MajenkoProjects/RTmFM/RTmFM.kicad_pcb

## KiCad design RTmFM.kicad_pcb (2026-05-27)

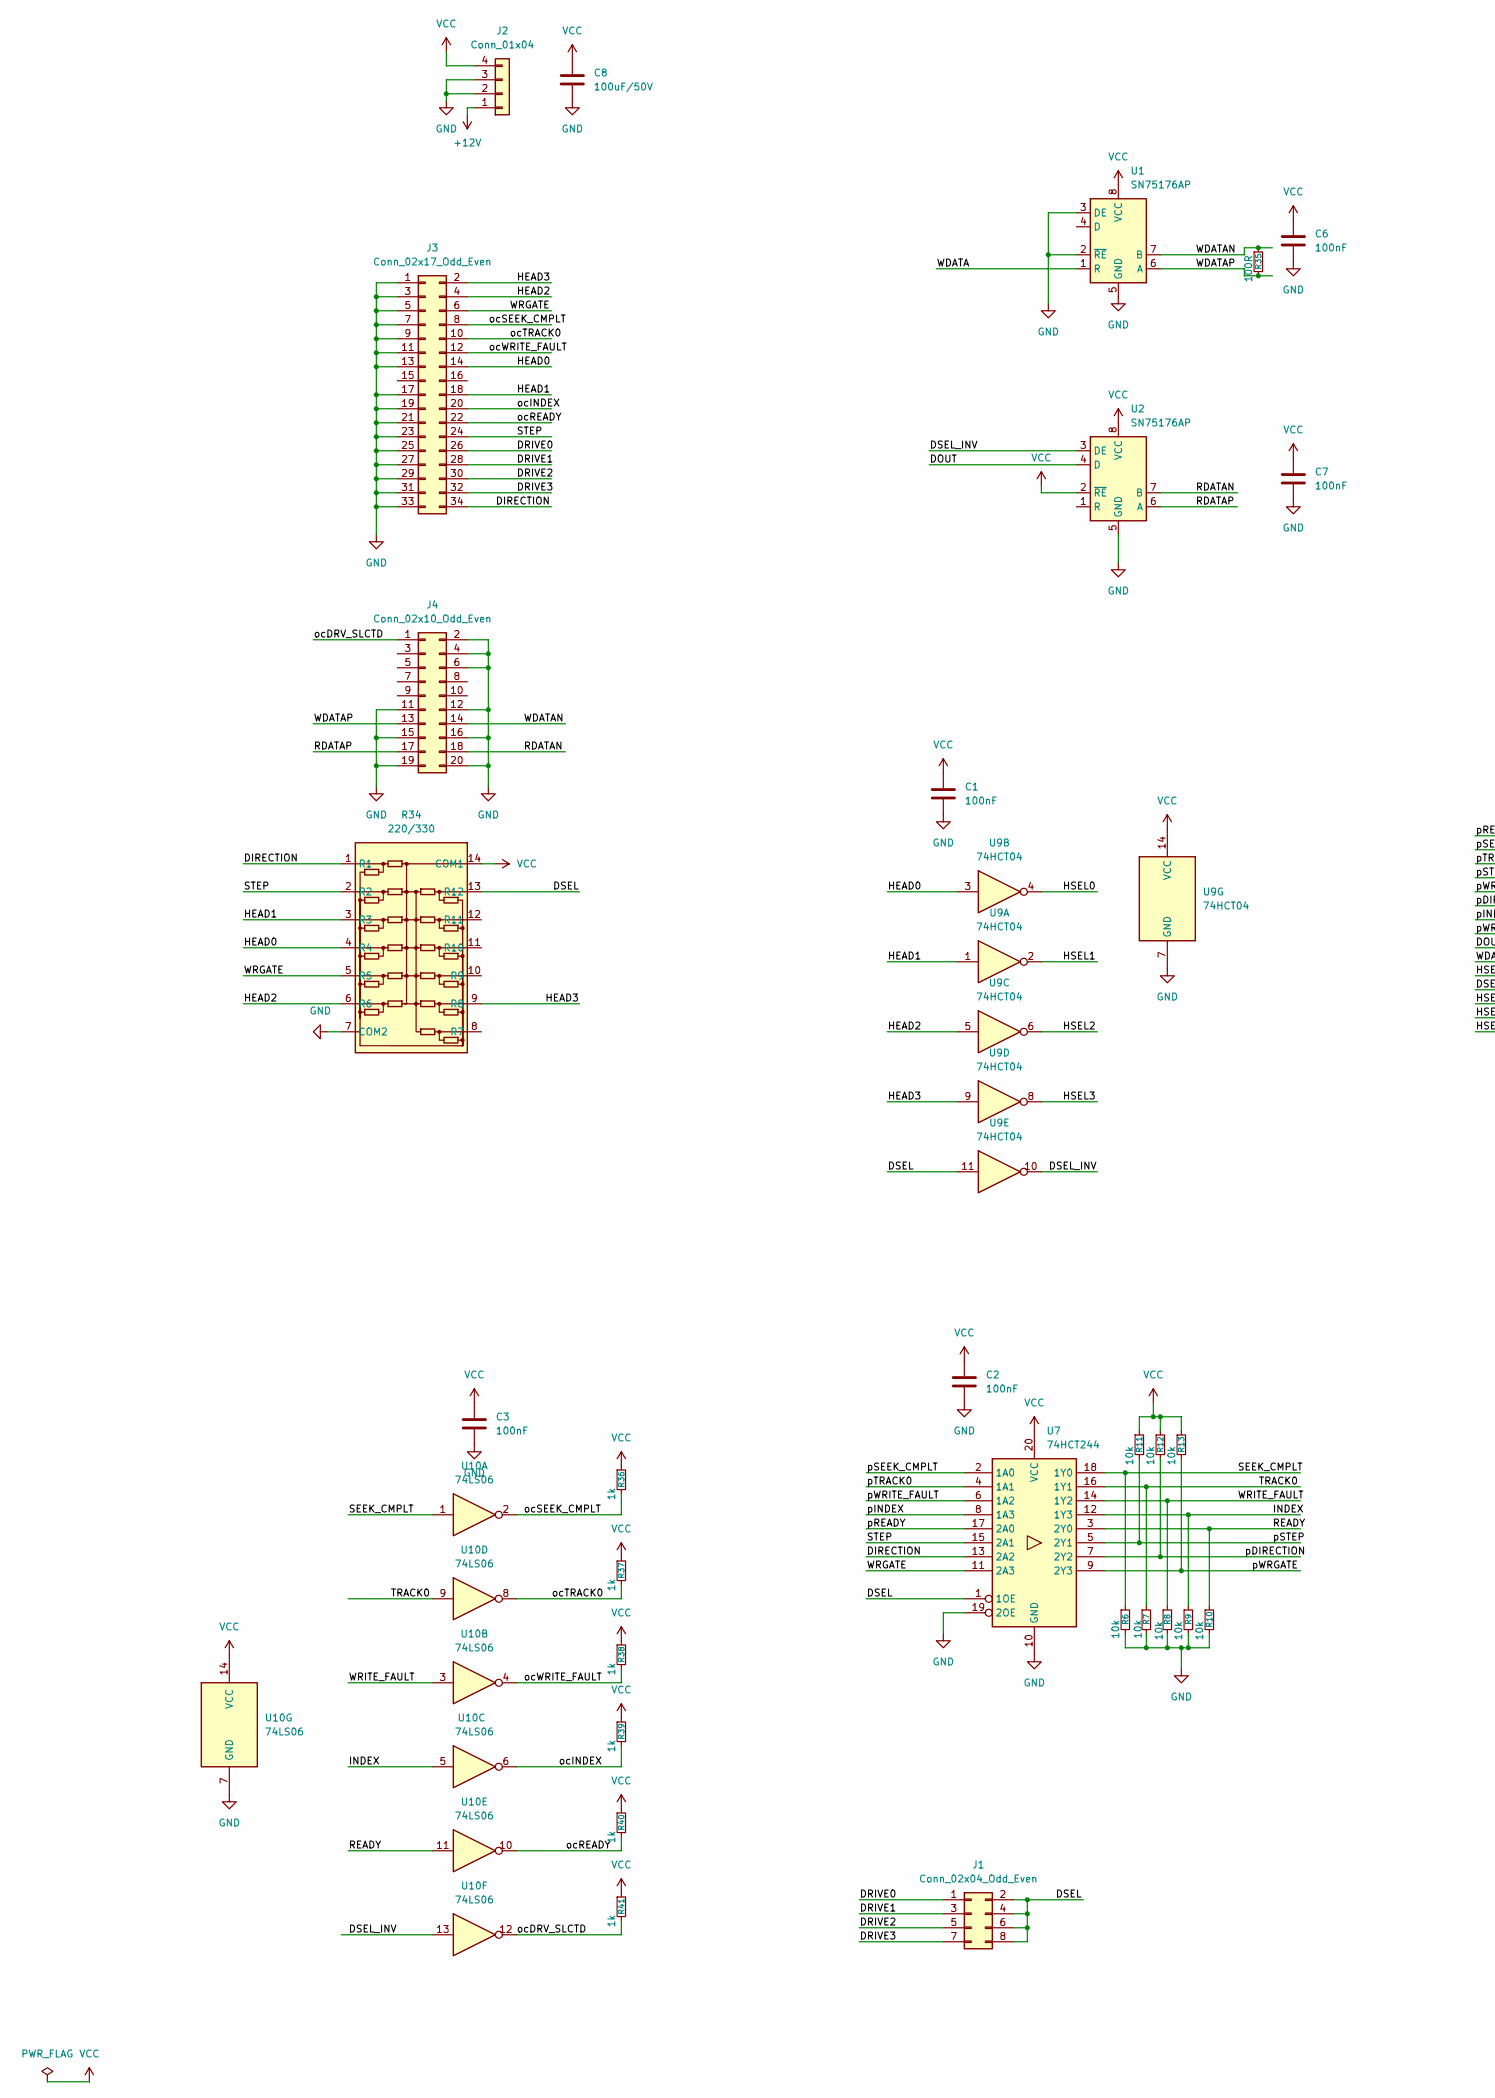
[picture p1: schematic RTmFM.kicad_sch, part in row 1, column 1]

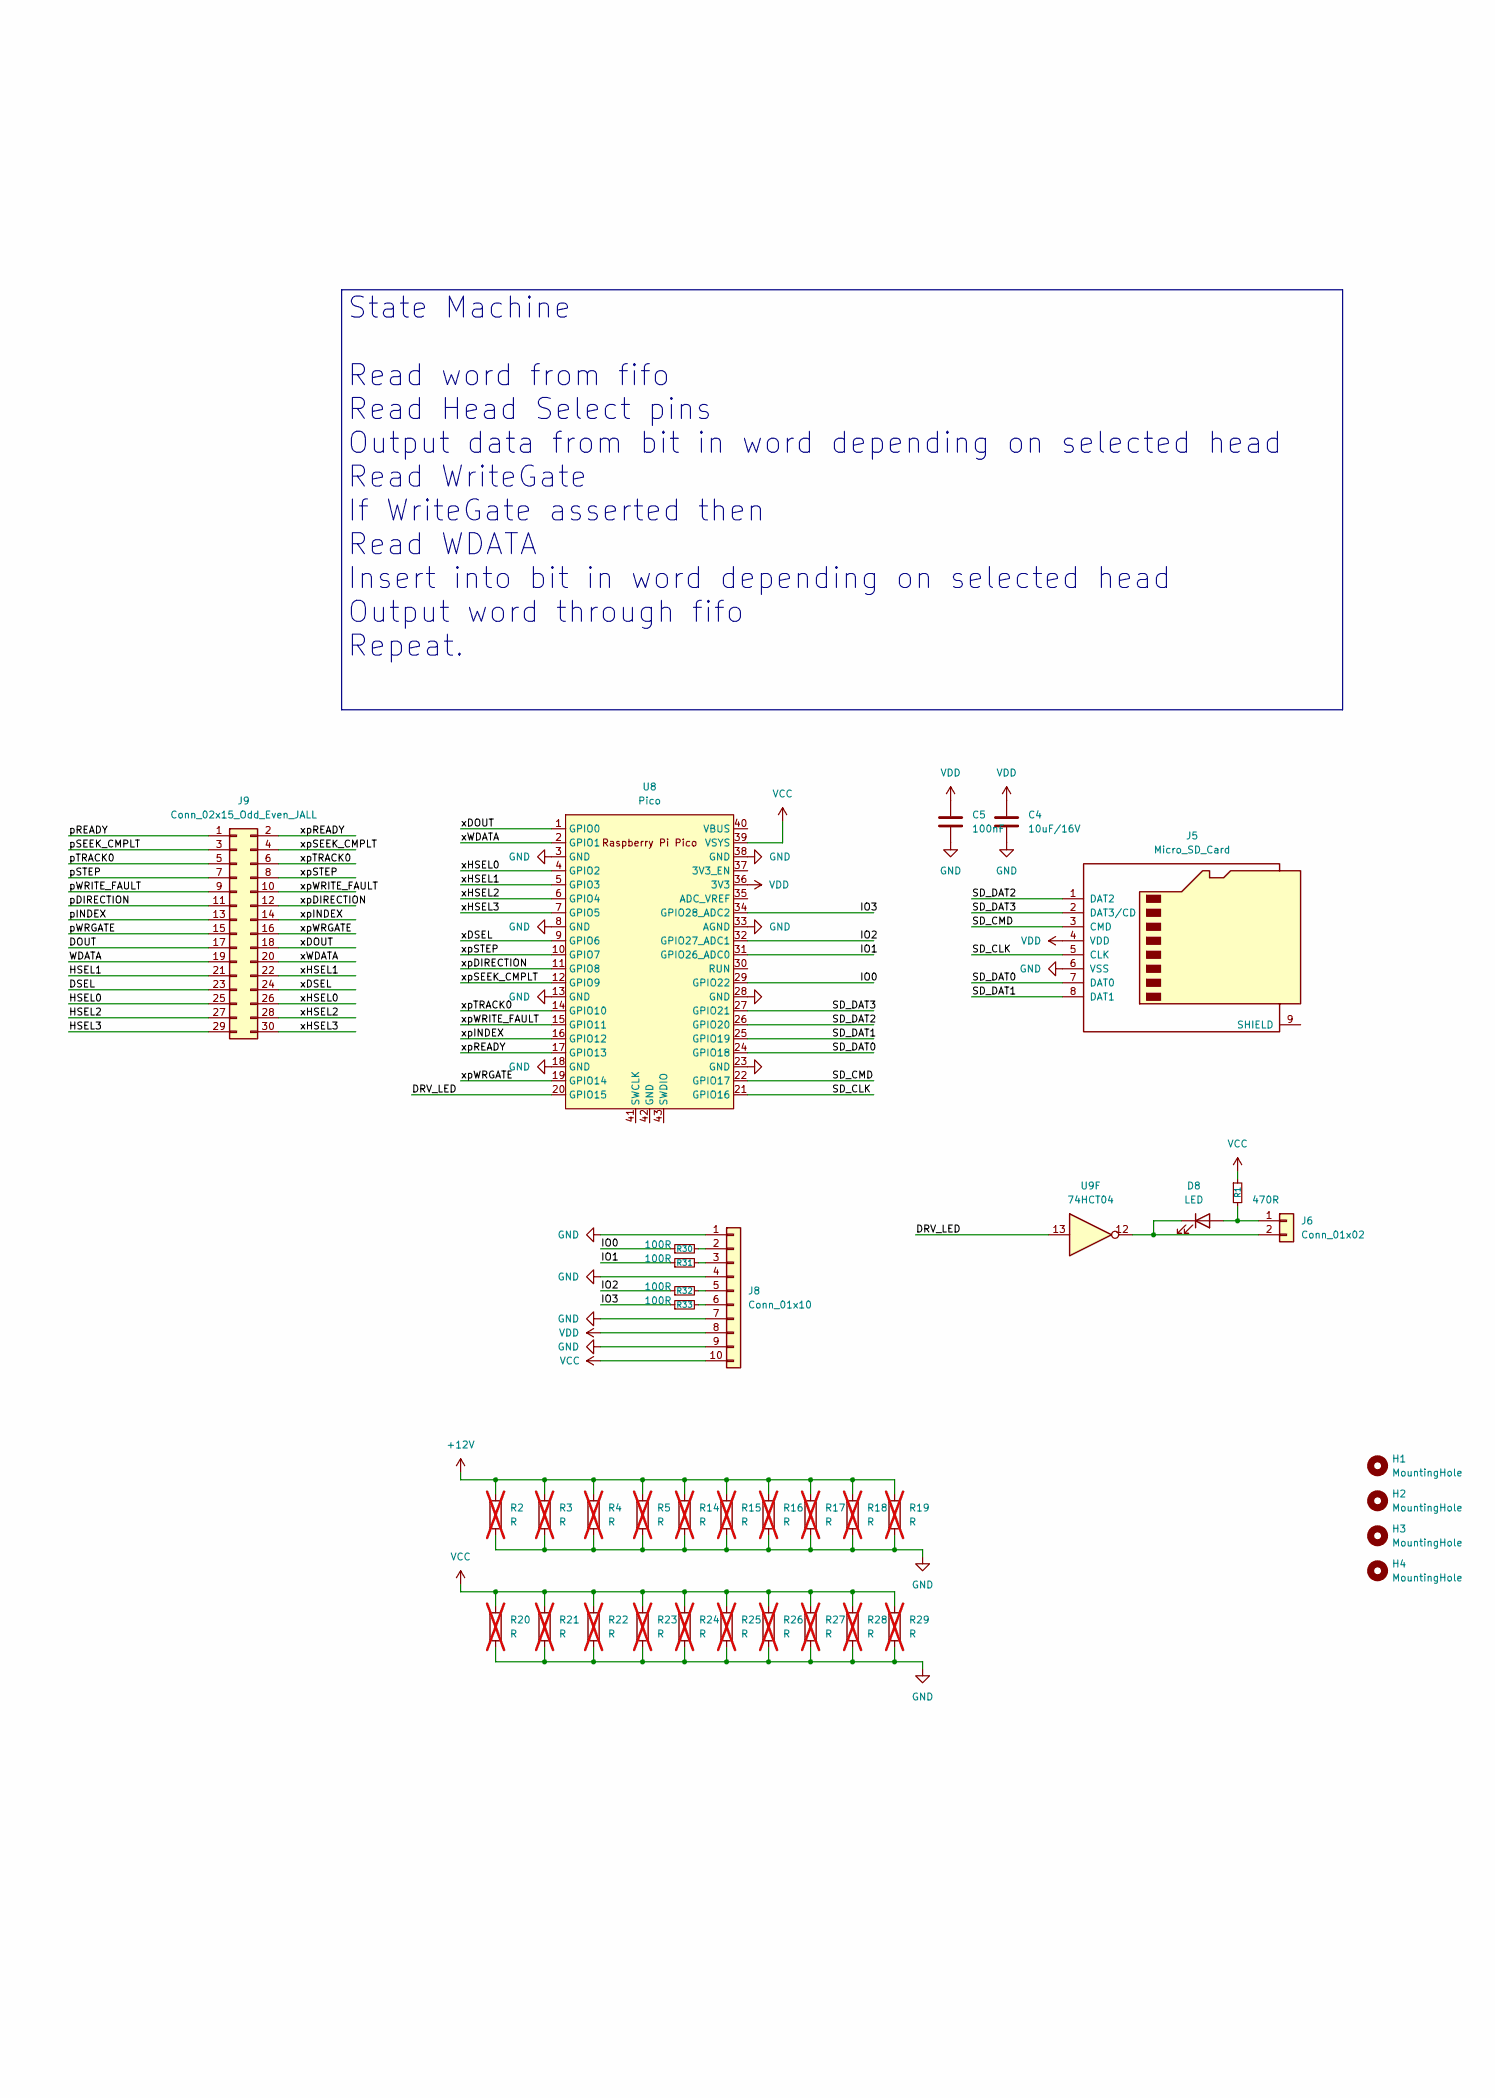
[picture p2: schematic RTmFM.kicad_sch, part in row 1, column 2]

Parts:
C1, C2, C3, C5, C6, C7: 100nF; C_Disc_D7.5mm_W2.5mm_P5.00mm
C4: 10uF/16V; CP_Radial_D5.0mm_P2.50mm
C8: 100uF/50V; CP_Radial_D8.0mm_P3.50mm
D8: LED; LED_Rectangular_W5.0mm_H2.0mm_Horizontal_O3.81mm_Z3.0mm
H1, H2, H3, H4: MountingHole; MountingHole_3.2mm_M3_DIN965_Pad_TopBottom
J1: Conn_02x04_Odd_Even; PinHeader_2x04_P2.54mm_Vertical
J2: Conn_01x04; TE_MATE-N-LOK_350211-1_1x04_P5.08mm_Vertical
J3: Conn_02x17_Odd_Even; PCB Edge 2.54 pitch 34 pin
J4: Conn_02x10_Odd_Even; PCB Edge 2.54 pitch 20 pin
J5: Micro_SD_Card; 503182-1852_MOL
J6: Conn_01x02; PinHeader_1x02_P2.54mm_Vertical
J8: Conn_01x10; PinHeader_1x10_P2.54mm_Vertical
J9: Conn_02x15_Odd_Even_JALL; PinHeader_2x15_P2.54mm_Vertical
R1: 470R; R_Axial_DIN0204_L3.6mm_D1.6mm_P7.62mm_Horizontal
R2, R3, R4, R5, R14, R15, R16, R17, R18, R19, R20, R21, R22, R23, R24, R25, R26, R27, R28, R29: R; R_Axial_Power_L20.0mm_W6.4mm_P25.40mm; not fitted
R6, R7, R8, R9, R10, R11, R12, R13: 10k; R_Axial_DIN0204_L3.6mm_D1.6mm_P7.62mm_Horizontal
R30, R31, R32, R33, R35: 100R; R_Axial_DIN0204_L3.6mm_D1.6mm_P7.62mm_Horizontal
R34: 220/330; DIP-14_W7.62mm_Socket
R36, R37, R38, R39, R40, R41: 1k; R_Axial_DIN0204_L3.6mm_D1.6mm_P7.62mm_Horizontal
U1, U2: SN75176AP; DIP-8_W7.62mm
U7: 74HCT244; DIP-20_W7.62mm
U8: Pico; RaspberryPi_Pico_Common_THT
U9: 74HCT04; DIP-14_W7.62mm
U10: 74LS06; DIP-14_W7.62mm

Connections:
+12V: J2.1, R2.1, R3.1, R4.1, R5.1, R14.1, R15.1, R16.1, R17.1, R18.1, R19.1
/DIRECTION: J3.34, R34.1 (R1), U7.13 (2A2)
/DOUT: J9.17, U2.4 (D)
/DRIVE0: J1.1, J3.26
/DRIVE1: J1.3, J3.28
/DRIVE2: J1.5, J3.30
/DRIVE3: J1.7, J3.32
/DRV_LED: U8.20 (GPIO15), U9.13
/DSEL: J1.2, J1.4, J1.6, J1.8, J9.23, R34.13 (R12), U7.1 (1OE), U9.11
/DSEL_INV: U2.3 (DE), U9.10, U10.13
/HEAD0: J3.14, R34.4 (R4), U9.3
/HEAD1: J3.18, R34.3 (R3), U9.1
/HEAD2: J3.4, R34.6 (R6), U9.5
/HEAD3: J3.2, R34.9 (R8), U9.9
/HSEL0: J9.25, U9.4
/HSEL1: J9.21, U9.2
/HSEL2: J9.27, U9.6
/HSEL3: J9.29, U9.8
/INDEX: R9.1, U7.12 (1Y3), U10.5
/IO0: R30.1, U8.29 (GPIO22)
/IO1: R31.1, U8.31 (GPIO26_ADC0)
/IO2: R32.1, U8.32 (GPIO27_ADC1)
/IO3: R33.1, U8.34 (GPIO28_ADC2)
/RDATAN: J4.18, U2.7 (B)
/RDATAP: J4.17, U2.6 (A)
/READY: R10.1, U7.3 (2Y0), U10.11
/SD_CLK: J5.5 (CLK), U8.21 (GPIO16)
/SD_CMD: J5.3 (CMD), U8.22 (GPIO17)
/SD_DAT0: J5.7 (DAT0), U8.24 (GPIO18)
/SD_DAT1: J5.8 (DAT1), U8.25 (GPIO19)
/SD_DAT2: J5.1 (DAT2), U8.26 (GPIO20)
/SD_DAT3: J5.2 (DAT3/CD), U8.27 (GPIO21)
/SEEK_CMPLT: R6.1, U7.18 (1Y0), U10.1
/STEP: J3.24, R34.2 (R2), U7.15 (2A1)
/TRACK0: R7.1, U7.16 (1Y1), U10.9
/WDATA: J9.19, U1.1 (R)
/WDATAN: J4.14, R35.1, U1.7 (B)
/WDATAP: J4.13, R35.2, U1.6 (A)
/WRGATE: J3.6, R34.5 (R5), U7.11 (2A3)
/WRITE_FAULT: R8.1, U7.14 (1Y2), U10.3
/ocDRV_SLCTD: J4.1, R41.2, U10.12
/ocINDEX: J3.20, R39.2, U10.6
/ocREADY: J3.22, R40.2, U10.10
/ocSEEK_CMPLT: J3.8, R36.2, U10.2
/ocTRACK0: J3.10, R37.2, U10.8
/ocWRITE_FAULT: J3.12, R38.2, U10.4
/pDIRECTION: J9.11, R12.2, U7.7 (2Y2)
/pINDEX: J9.13, U7.8 (1A3)
/pREADY: J9.1, U7.17 (2A0)
/pSEEK_CMPLT: J9.3, U7.2 (1A0)
/pSTEP: J9.7, R11.2, U7.5 (2Y1)
/pTRACK0: J9.5, U7.4 (1A1)
/pWRGATE: J9.15, R13.2, U7.9 (2Y3)
/pWRITE_FAULT: J9.9, U7.6 (1A2)
/xDOUT: J9.18, U8.1 (GPIO0)
/xDSEL: J9.24, U8.9 (GPIO6)
/xHSEL0: J9.26, U8.4 (GPIO2)
/xHSEL1: J9.22, U8.5 (GPIO3)
/xHSEL2: J9.28, U8.6 (GPIO4)
/xHSEL3: J9.30, U8.7 (GPIO5)
/xWDATA: J9.20, U8.2 (GPIO1)
/xpDIRECTION: J9.12, U8.11 (GPIO8)
/xpINDEX: J9.14, U8.16 (GPIO12)
/xpREADY: J9.2, U8.17 (GPIO13)
/xpSEEK_CMPLT: J9.4, U8.12 (GPIO9)
/xpSTEP: J9.8, U8.10 (GPIO7)
/xpTRACK0: J9.6, U8.14 (GPIO10)
/xpWRGATE: J9.16, U8.19 (GPIO14)
/xpWRITE_FAULT: J9.10, U8.15 (GPIO11)
GND: C1.2, C2.2, C3.2, C4.2, C5.2, C6.2, C7.2, C8.2, J2.2, J2.3, J3.1, J3.3, J3.5, J3.7, J3.9, J3.11, J3.13, J3.17, J3.19, J3.21, J3.23, J3.25, J3.27, J3.29, J3.31, J3.33, J4.2, J4.4, J4.6, J4.11, J4.12, J4.15, J4.16, J4.19, J4.20, J5.6 (VSS), J8.1, J8.4, J8.7, J8.9, R2.2, R3.2, R4.2, R5.2, R6.2, R7.2, R8.2, R9.2, R10.2, R14.2, R15.2, R16.2, R17.2, R18.2, R19.2, R20.2, R21.2, R22.2, R23.2, R24.2, R25.2, R26.2, R27.2, R28.2, R29.2, R34.7 (COM2), U1.2 (~RE), U1.3 (DE), U1.5 (GND), U2.5 (GND), U7.10 (GND), U7.19 (2OE), U8.3 (GND), U8.8 (GND), U8.13 (GND), U8.18 (GND), U8.23 (GND), U8.28 (GND), U8.33 (AGND), U8.38 (GND), U9.7 (GND), U10.7 (GND)
unnamed: D8.2 (A), J6.1, R1.2
unnamed: D8.1 (K), J6.2, U9.12
unnamed: J8.2, R30.2
unnamed: J8.3, R31.2
unnamed: J8.5, R32.2
unnamed: J8.6, R33.2
VCC: C1.1, C2.1, C3.1, C6.1, C7.1, C8.1, J2.4, J8.10, R1.1, R11.1, R12.1, R13.1, R20.1, R21.1, R22.1, R23.1, R24.1, R25.1, R26.1, R27.1, R28.1, R29.1, R34.14 (COM1), R36.1, R37.1, R38.1, R39.1, R40.1, R41.1, U1.8 (VCC), U2.2 (~RE), U2.8 (VCC), U7.20 (VCC), U8.39 (VSYS), U9.14 (VCC), U10.14 (VCC)
VDD: C4.1, C5.1, J5.4 (VDD), J8.8, U8.36 (3V3)

Notes on the sheet:
State Machine Read word from fifo Read Head Select pins Output data from bit in word depending on selected head Read WriteGate If WriteGate asserted then Read WDATA Insert into bit in word depending on selected head Output word through fifo Repeat.

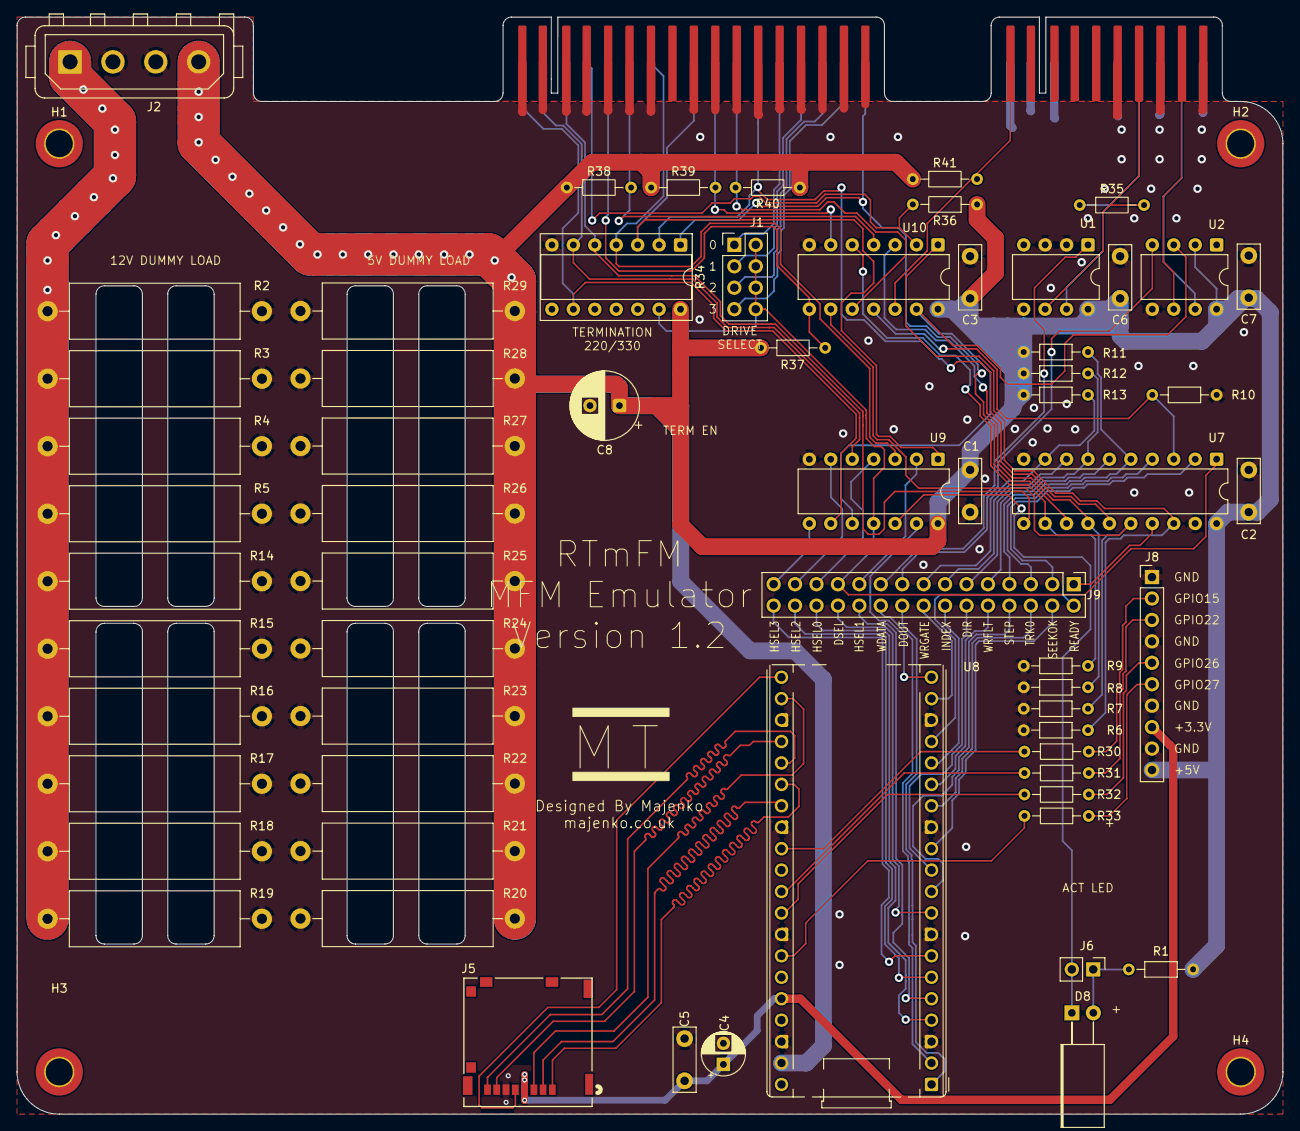
[picture p3: board RTmFM.kicad_pcb from above]

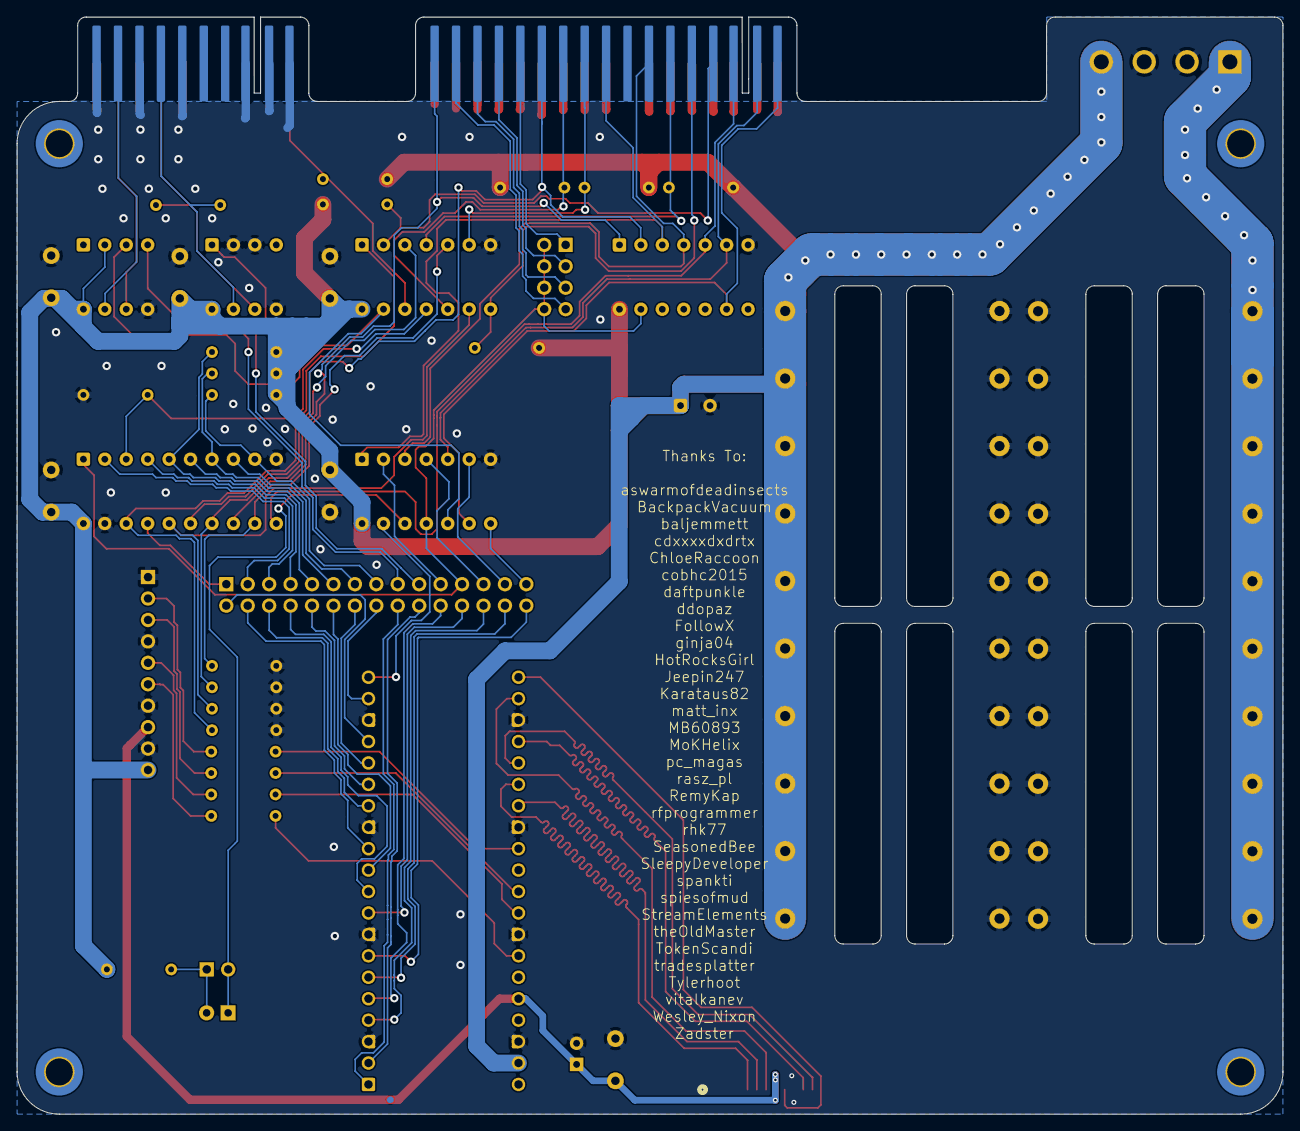
[picture p4: board RTmFM.kicad_pcb from below]

Board: 2 copper layers, 150.0 x 130.0 mm, 68 parts (2 on the bottom side), 78 nets.
