MajenkoProjects/RTmFM/(commit log)

2025-05-01 Initial import
    [RTmFM.kicad_pcb, RTmFM.kicad_sch]
2025-05-02 Bus interface
    [RTmFM.kicad_sch]
2025-05-08 Fixed footprints and started layout
    [RTmFM.kicad_pcb, RTmFM.kicad_sch]
2025-05-15 Almost finished HW design
    [RTmFM.kicad_pcb, RTmFM.kicad_sch]
2025-05-19 End of version 1 design
    [RTmFM.kicad_pcb, RTmFM.kicad_sch]
2025-09-03 Reversed bit ordering to make more sense
    [Test.ino]
2025-09-04 Full track streaming and CLI interface
2025-09-05 Rework SD interface and add head 4
    [RTmFM.kicad_pcb, RTmFM.kicad_sch]
2025-09-08 Version 1.1 rework
    [RTmFM.kicad_pcb, RTmFM.kicad_sch]
2025-10-23 Revision 1.1 and working data out
    [RTmFM-NPTH.drl, RTmFM-job.gbrjob, RTmFM.GBL, RTmFM.GBO, RTmFM.GBS, RTmFM.GTL, RTmFM.GTO, RTmFM.GTS]
2026-02-12 Found the seek bug at last (thanks ben)
    [Test.ino]
2026-05-27 Fixed bus interfacing
    [RTmFM.kicad_pcb, RTmFM.kicad_sch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]
